nppc/MashController/README.md

# MashController

MashController is a home brewing automation project built to control the mash process with a small ESP8266-based controller. The goal is to make mash temperature easier to manage, more stable, and less dependent on constant manual intervention.

This project is designed for a brewer who wants a simple device that can measure temperature, control a heater, run a mixer, and expose a browser-based interface for monitoring and calibration.

## Safety Notice

This project is intended for educational and hobby use.
The software is provided without any warranty. Users are responsible for verifying that the system operates safely in their specific environment.
The author accepts no responsibility for any damage, injury, material loss, or other consequences resulting from the use of this project.
By using this software, you acknowledge that all operation is performed at your own risk.

## What this project does

During mashing, the temperature must stay within a fairly narrow range to support the desired enzymatic activity and conversion. MashController helps by continuously monitoring the mash temperature and adjusting the heating output to keep it near the target value. It also manages the mixer so the mash stays well mixed and the temperature remains consistent throughout the vessel.

## Heater temperature control logic

The heater control is model-based and predictive, not simple threshold switching. The controller keeps a calibrated thermal model of the heating element's stored heat, and on every cycle predicts the peak temperature the mash will coast to if the heater switched off right now — accounting for residual stored heat and loss to ambient.
It switches on when that predicted peak drops below target minus a deadband, and switches off once the predicted peak reaches target — turning off before the sensor shows target, anticipating the heat still flowing in. A minimum switch-lock interval prevents rapid cycling. The result: stable, repeatable mash temperature with minimal overshoot, since the controller reacts to where temperature is heading, not just where it is now.

> **Why not PID?** A PID controller suits outputs that can be varied smoothly and processes that respond quickly. Here the heater is only fully on or off, and the response is slow and delayed by stored heat, sensor lag and the mixer cycle. Even with autotuning, PID only works acceptably within a narrow setup window, and a different volume or mash needs retuning.

## Mixer logic

The mixer logic is intended to keep the mash moving while the heater is active. A mash can develop temperature gradients, especially in a vessel with a heating element near the bottom, where the liquid close to the heater becomes warmer than the rest. The mixer helps prevent that by circulating the mash and blending warmer and cooler zones together.

This improves consistency, reduces hot spots, and helps the system hold a more uniform temperature across the vessel.

## Profiles

A profile is a complete mash schedule: a list of temperature steps (up to 6), each with a target temperature and a duration. Up to 15 profiles can be stored on the device. They are edited on the Profiles screen and started from the Home screen, where the active step and remaining time are shown.

A step with its time set to 0 is a manual step: the controller heats to the target temperature and then waits until you press RESUME, for example to add grain. While a profile runs it can be paused, resumed, skipped to the next step or stopped. After the last step the mixer keeps running for a configurable cool-down time if needed.

The temperature chart shows an approximate program time remaining alongside the current ramp estimate. It includes estimated heating ramps and timed steps, pauses whenever the profile is paused, and excludes cooldown and manual waiting time.

Heater calibration is performed with plain water. During a mash, the controller adds an estimated grain heat capacity after you resume the first zero-duration manual step. Set that first step to the temperature where you add grain, add the grain when prompted, then press RESUME. The grain adjustment remains active for later steps. It accounts for grain mass, but does not model the grain's starting temperature or mixing effects.

When a manual step reaches its target temperature, the browser plays a soft chime, repeats it every 20 seconds until you press RESUME or STOP, and flashes the tab title. Browsers block sound until the page has been tapped once (for example after a refresh), so a yellow bar appears while a process is running to let you enable it. The alert can be switched off in Settings (**Sound Alerts**), and **Target Reached Tolerance** sets how many degrees below the target still counts as reached.

## Heater calibration

The DS18B20 sensor is factory-calibrated, so the sensor itself is not calibrated. What is calibrated is the **heater**. The element and pot base store heat, which keeps flowing into the water after switch-off, so the temperature overshoots. An automatic test on plain water (see the calibration page) measures the time constant (τ), effective power, store gain and heat loss of your setup, and the controller uses them to switch off early by the right amount.

> **Safety:** never leave the heater running unattended during calibration, and do not add grain.

## Features

- Temperature regulation for the mash process
- Heater control based on live sensor feedback
- Mixer control to keep the mash evenly mixed
- Mash profiles with up to 6 temperature steps each, including manual (wait for RESUME) steps, and up to 15 stored profiles
- Pause, resume and skip controls while a profile is running
- Audible browser alert when a manual step reaches its temperature
- Browser-based dashboard for monitoring and configuration
- Dual Wi-Fi modes: standalone Local Access Point (AP) and External Wi-Fi (Station) with automatic 2-minute AP fallback
- Local domain resolution via mDNS (`http://mash.local`) and NetBIOS (`http://mash`), configurable in Settings
- Emergency double-reset recovery to restore default AP credentials without losing settings, profiles, or calibration data
- Temporary simulated sensor mode and adjustable simulation speed for testing; real heater, mixer and cooler outputs are disabled in this mode
- Automatic heater calibration (time constant, effective power, store gain, heat loss)
- Over-the-Air (OTA) update support for both firmware and LittleFS filesystem images, with automatic GZIP compression (`.bin.gz`)

## Screenshots

<table>
  <tr>
    <td valign="top" align="center">
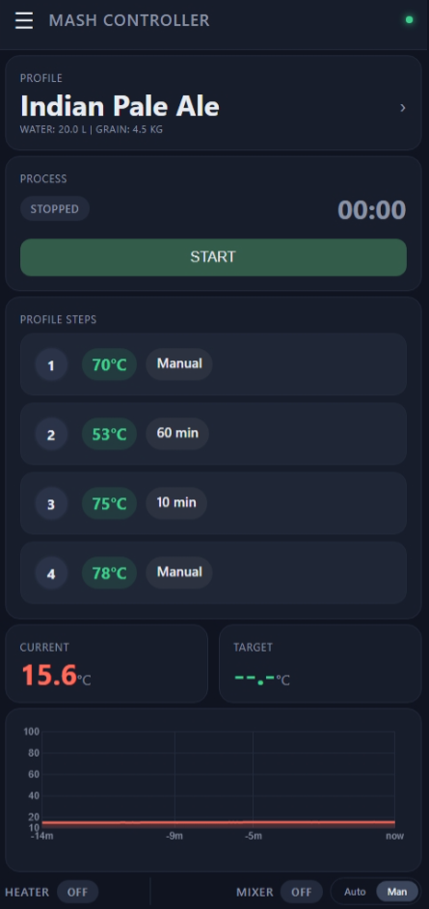
[picture p1: Images/main.png]
Main Dashboard
      <br>
      <b>Main Dashboard</b>
    </td>
    <td valign="top" align="center">
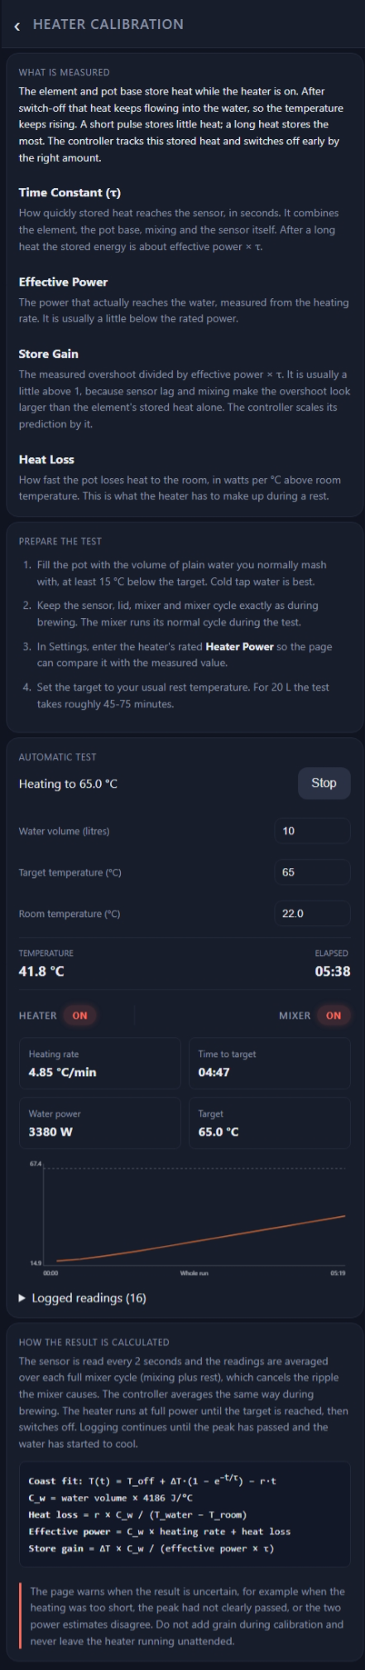
[picture p2: Images/calibration.png]
Heater Calibration
      <br>
      <b>Heater Calibration</b>
    </td>
  </tr>
</table>

## Hardware

The wiring diagram below shows how the Wemos D1 mini is connected to the sensor, heater, mixer and cooler.

<p align="center">
  MashController wiring schematic
</p>

### Parts

- Wemos D1 mini (ESP8266)
- DS18B20 temperature sensor with a 4.7 kΩ pull-up resistor to 3V3
- Solid-state relay (SSR), 25 A, for the heater (mains side)
- Heater element under the mash pot
- 19 V / 4.2 A AC/DC power adapter (notebook adapter)
- Buck (DC/DC) converter, 19 V to 5 V, for the Wemos and the fan
- Mixer driver (default, inverted): small-signal N-MOSFET (Q1) pulling down the gate of an IRFZ30 (Q2), with a 10 kΩ gate pull-up to the 19 V rail. A single logic-level N-MOSFET driven directly by the GPIO also works, see [Mixer drive polarity](#mixer-drive-polarity)
- Inverted drive only: 10 kΩ pull-up from D5 to 3V3, so the mixer stays off while the ESP8266 boots
- 24VDC mixer motor
- 5 V cooling fan for the SSR, switched by a second N-MOSFET module (optional, see below)

### Pin assignment

| Function | Wemos pin | Connected to |
| --- | --- | --- |
| `ONE_WIRE_BUS` | D1 | DS18B20 data (DQ) |
| `HEATER_PIN` | D2 | SSR input (IN+) |
| `MIXER_PIN` | D5 | Inverted drive (default): Q1 gate, active-low, GPIO LOW = mixer on. Non-inverted drive: MOSFET gate, active-high, GPIO HIGH = mixer on |
| `COOLER_PIN` | D6 | Fan MOSFET module (SIG) |

The pins are defined in `Config.h`.

### Mixer drive polarity

The mixer polarity is set by `MIXER_OUTPUT_INVERTED` in `Config.h`:

| `MIXER_OUTPUT_INVERTED` | Mixer driver | GPIO level for mixer on |
| --- | --- | --- |
| `1` (default) | Q1 pulling down the gate of Q2 (as in the schematic) | LOW |
| `0` | One logic-level N-MOSFET driven directly by the GPIO | HIGH |

Q1 inverts the signal, which is why the default drive is active-low. With a single N-MOSFET no inversion is needed, so set the define to `0`. Keep the mixer off while the ESP8266 boots: the 10 kΩ pull-up to 3V3 does this for the inverted drive, while a non-inverted drive needs a pull-down instead (for example 10 kΩ from the gate to GND).

**Fan control is optional.** The fan MOSFET module and `COOLER_PIN` (D6) can be omitted. In that case, connect the fan directly to the 5 V rail (fan + to 5 V, fan − to GND), and it will run continuously.

> **Warning:** the SSR switches mains voltage. Mount it on a heatsink, use a properly rated and enclosed installation, and never work on the mains wiring while it is connected to power. A flyback diode across the motor and the fan is recommended; it is not drawn in the schematic.

## Network and Wi-Fi

MashController provides two operating modes for Wi-Fi, selectable in Settings:

### 1. Local AP Mode (Default)
When active, the controller creates its own Wi-Fi Access Point:
- **Default SSID:** `MashController`
- **Default IP:** `192.168.4.1` (or `http://mash.local`)
- **Password:** Optional. Leave empty for an open network, or enter an 8+ character WPA2 password.

### 2. External Wi-Fi Mode (Station)
Connects to your home Wi-Fi network as a client:
- Automatically requests an IP address via DHCP (compatible with router DHCP Address Reservations).
- **Automatic AP Fallback:** If the external network cannot be reached within 2 minutes (e.g. router rebooting, out of range, or wrong password), the controller automatically starts its Local AP so you can still access the interface, while continuing background reconnection retries.

### Emergency AP Recovery (Double-Reset)
If you ever forget the AP password or lose network access:
- Power-cycle or press the hardware reset button **twice within 10 seconds**.
- The controller temporarily resets the AP credentials to default (`MashController`, open network), allowing you to connect and reconfigure. Your mash profiles and calibration parameters are preserved.

### Local Domain Resolution (mDNS & NetBIOS)
- When enabled (default), you can reach the controller by name without looking up its assigned IP:
  - **`http://mash.local`** via Multicast DNS (mDNS) on iOS, macOS, Android, Linux, and Windows.
  - **`http://mash`** on Windows via NetBIOS Name Service (NBNS).
- **Enable / Disable Toggle:** If you assign a static router DHCP/DNS reservation or prefer IP-only access, toggle **mash.local Domain** off in Settings. This cleanly shuts down both mDNS and NetBIOS responders.

## Over-The-Air (OTA) Updates

Firmware and LittleFS filesystem updates can be uploaded directly over Wi-Fi:

1. Open **`http://<controller-ip>/enable-ota`** in a browser to unlock the 5-minute update window.
2. Select your file:
   - **Firmware:** `.pio/build/d1_mini/firmware.bin` or compressed **`firmware.bin.gz`**
   - **LittleFS Filesystem:** `.pio/build/d1_mini/littlefs.bin` or compressed **`littlefs.bin.gz`**
3. Click upload. PlatformIO automatically generates both `.bin` and `.bin.gz` files on compile (`pio run` / `pio run --target buildfs`). Uploading `.bin.gz` files reduces transfer size by ~30% for firmware and ~80% for filesystem images; the bootloader decompresses them atomically on restart.

## Getting Started

1. Clone the repository.
2. Open the project in [PlatformIO](https://platformio.org/).
3. Build and upload the firmware to your ESP8266 board (`pio run --target upload`).
4. Build and upload the filesystem image (`pio run --target uploadfs`).
5. Power up the controller. Connect to the `MashController` Wi-Fi network and open `http://192.168.4.1` (or `http://mash.local`) in your browser.
6. In **Settings**, configure your network:
   - Keep **Local AP** mode or switch to **External Wi-Fi** to connect to your home router.
   - Adjust the **mash.local Domain** toggle if desired.
7. Run Autocalibration for your heater setup on the Calibration page.

## License

This project is licensed under the MIT License.
