nppc/MashController/MashController_pio/data/PredictivePeakDeadband.png

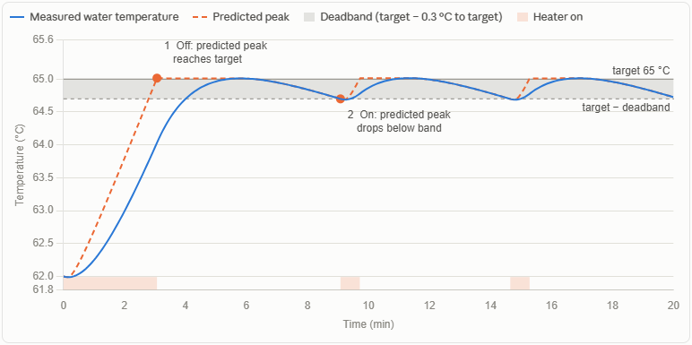
MashController_pio/data/PredictivePeakDeadband.png
