nppc/MashController/MashController_pio/include/Config.h

#ifndef CONFIG_H
#define CONFIG_H

#include <Arduino.h>

#define ONE_WIRE_BUS D1

// Heater SSR: driven directly, active-high (GPIO HIGH -> SSR on).
#define HEATER_PIN D2

// Mixer motor: GPIO drives a small-signal N-MOSFET which, in turn, pulls
// down the gate of the high-power IRFZ30 (pulled up externally to the
// gate-supply rail). That makes this channel ACTIVE-LOW from the GPIO's
// perspective:
//   GPIO HIGH -> small-signal FET ON  -> IRFZ30 gate LOW  -> motor OFF
//   GPIO LOW  -> small-signal FET OFF -> IRFZ30 gate HIGH -> motor ON
// Add an external pull-up (GPIO to 3.3V) on this pin so the motor
// defaults OFF during the boot window before setup() runs.
#define MIXER_PIN D5
// Set to 1 to keep the current active-low mixer drive behavior (GPIO HIGH = off).
// Set to 0 for a non-inverted drive (GPIO HIGH = on).
#define MIXER_OUTPUT_INVERTED 1

#define COOLER_PIN D6

#define HISTORY_SIZE 180
#define READ_INTERVAL_MS 2000UL
#define CONVERSION_TIME_MS 750UL   // 12-bit resolution conversion time

#define RESIDUAL_HEAT_RECOVERY_THRESHOLD_C 35.0f
#define RESIDUAL_HEAT_RECOVERY_WINDOW_MS 60000UL
#define RESIDUAL_HEAT_RECOVERY_MAX_RISE_C 0.1f

#endif
