nppc/MashController/MashController_pio/src/Storage.cpp

#include "Storage.h"

/* ============================================================================
 * HOW TO USE STORED SETTINGS ACROSS THIS PROJECT
 * ============================================================================
 *
 * `storage` (declared below) is the single global instance. Call
 * `storage.begin()` once from setup() before anything touches it; it loads
 * from EEPROM, migrates older layouts if needed, or writes defaults on first
 * boot / corruption.
 *
 * READING A SETTING (any .cpp file, anywhere in the project):
 *   #include "Storage.h"
 *   float ambient = storage.settings().heaterAmbientC;
 *
 *   `storage.settings()` returns a REFERENCE to the live in-RAM struct
 *   (_data.settings) - not a copy. There is no separate cache to go stale,
 *   so every read reflects the current value, including one changed a
 *   moment ago by a web handler on the same tick. This is how Sensor.cpp's
 *   fakeReadTemperature() picks up heaterAmbientC changes immediately.
 *
 * WRITING A SETTING (e.g. from a web handler):
 *   SettingsEE &s = storage.settings();
 *   s.heaterAmbientC = constrain(newValue, -10.0f, 45.0f);
 *   storage.save();   // <-- REQUIRED to persist to EEPROM
 *
 *   The struct mutation itself takes effect in RAM instantly, for every
 *   other piece of code holding or fetching a reference. `storage.save()`
 *   only controls whether the change SURVIVES A REBOOT - it recomputes the
 *   CRC and writes the whole `_data` blob via EEPROM.commit(). Skipping
 *   save() means the running system behaves correctly but reverts to the
 *   old value on next boot. Always constrain/validate before assigning;
 *   save() does not validate for you (see handleSaveSettings in
 *   WebHandlers.cpp for the pattern of per-field constrain() calls).
 *
 * PROFILES ARE DIFFERENT - NOT A LIVE REFERENCE:
 *   storage.getProfile(index, out)   // copies into `out`
 *   storage.setProfile(index, p)     // copies `p` in (index == count appends)
 *   storage.deleteProfile(index)
 *   storage.clearProfiles()
 *   Profiles are accessed by value, not by reference, so mutate your local
 *   copy and call setProfile() to write it back - then storage.save() to
 *   persist, same as settings.
 *

 * ADDING A NEW SETTING FIELD:
 *   1. Add the field to `SettingsEE` in Storage.h.
 *   2. Give it a sane default in applyHeaterDefaults() (heater-related),
 *      applyMixerDefaults() (mixer/cool-down) or directly in
 *      Storage::loadDefaults() (everything else). Every migration and
 *      loadDefaults() call these helpers first, so a field defaulted there
 *      never ends up as 0 after a memset().
 *   3. If this changes the struct's layout/size, bump STORAGE_VERSION.
 *      The static_assert next to LegacyV12SettingsEE will fail the build
 *      until you:
 *        (a) copy the OLD SettingsEE into a new LegacyV<old>SettingsEE /
 *            LegacyV<old>EepromDataEE pair,
 *        (b) delete the previous Legacy struct pair,
 *        (c) update STORAGE_PREVIOUS_VERSION in Storage.h,
 *        (d) rewrite the migration block in begin() for the new legacy
 *            struct (call the apply*Defaults() helpers, then copy over
 *            every field that existed before).
 *      POLICY: only ONE previous version is migrated. Anything older is
 *      reset to defaults by loadDefaults().
 *      If ProfileEE itself changes, also snapshot the old profile struct
 *      inside the Legacy pair (see how LegacyV10ProfileEE used to be done),
 *      because the Legacy layout embeds ProfileEE.
 * ==========================================================================
 */

Storage storage;

namespace {

// ---- Previous layout (version STORAGE_PREVIOUS_VERSION) -------------------
// Layout of version 15 (before mdnsEnabled was added).
struct LegacyV15SettingsEE {
  uint8_t  wifiMode;
  char     wifiApSSID[STORAGE_SSID_LEN];
  char     wifiApPass[STORAGE_PASS_LEN];
  char     wifiStaSSID[STORAGE_SSID_LEN];
  char     wifiStaPass[STORAGE_PASS_LEN];
  float    heaterPowerW;
  float    heaterPowerEffW;
  float    heaterTauSec;
  float    heaterStoreGain;
  float    heaterLossWPerC;
  float    heaterAmbientC;
  float    heaterDeadband;
  uint16_t heaterMinSwitchSec;
  float    heaterT1;
  float    heaterTau1;
  float    heaterLossW1;
  float    heaterStoreGain1;
  float    heaterT2;
  float    heaterTau2;
  float    heaterLossW2;
  float    heaterStoreGain2;
  float    heaterTrimLowC;
  float    heaterTrimHighC;
  float    heaterLossScalePct;
  uint8_t  mixerRestSec;
  uint8_t  mixerOnSec;
  uint16_t coolDownSec;
  float    targetReachedHystC;
  bool     alertSoundEnabled;
};

struct LegacyV15EepromDataEE {
  uint32_t             magic;
  uint16_t             version;
  LegacyV15SettingsEE  settings;
  uint8_t              profileCount;
  ProfileEE            profiles[STORAGE_MAX_PROFILES];
  uint32_t             crc;
};

// Build breaks here when STORAGE_VERSION is bumped without updating the
// migration. See "ADDING A NEW SETTING FIELD" at the top of this file.
static_assert(STORAGE_VERSION == STORAGE_PREVIOUS_VERSION + 1,
              "STORAGE_VERSION was bumped: snapshot the old SettingsEE as "
              "LegacyV<old>SettingsEE, update STORAGE_PREVIOUS_VERSION, "
              "migrate it in begin(), and delete the older Legacy struct.");
static_assert(STORAGE_PREVIOUS_VERSION == 15,
              "STORAGE_PREVIOUS_VERSION no longer matches LegacyV15* - "
              "rename/replace the Legacy struct and migration block.");

// Uncalibrated starting point for a 2 kW under-base element; run the
// Heater Calibration page to replace these with measured values.
void applyHeaterDefaults(SettingsEE &s) {
  s.heaterPowerW = 2000.0f;
  s.heaterPowerEffW = 1900.0f;
  s.heaterTauSec = 90.0f;
  s.heaterStoreGain = 1.0f;
  s.heaterLossWPerC = 4.0f;
  s.heaterAmbientC = 20.0f;
  s.heaterDeadband = 0.05f;
  s.heaterMinSwitchSec = 5;

  s.heaterT1 = 50.0f;
  s.heaterTau1 = 115.0f;
  s.heaterLossW1 = 65.0f;
  s.heaterStoreGain1 = 0.85f;
  s.heaterT2 = 70.0f;
  s.heaterTau2 = 95.0f;
  s.heaterLossW2 = 150.0f;
  s.heaterStoreGain2 = 0.88f;

  s.heaterTrimLowC = 0.0f;
  s.heaterTrimHighC = 0.0f;
  s.heaterLossScalePct = 100.0f;

  // Not heater values, but seeded here because every migration path and
  // loadDefaults() already call this helper.
  s.targetReachedHystC = 0.5f;   // was hardcoded in mashProfileTick()
  s.alertSoundEnabled = true;
  s.mdnsEnabled = true;
}

void applyMixerDefaults(SettingsEE &s) {
  s.mixerRestSec = 15;
  s.mixerOnSec   = 5;
  s.coolDownSec  = 180;   // 3 minutes default
}
}

bool Storage::begin() {
  EEPROM.begin(sizeof(EepromDataEE));
  EEPROM.get(0, _data);

  uint32_t storedCrc = _data.crc;
  uint32_t calc = crc32((uint8_t*)&_data, sizeof(EepromDataEE) - sizeof(_data.crc));

  if (_data.magic != STORAGE_MAGIC || _data.version != STORAGE_VERSION || storedCrc != calc) {
    LegacyV15EepromDataEE legacyV15;
    EEPROM.get(0, legacyV15);
    uint32_t legacyV15Calc = crc32(
        (uint8_t*)&legacyV15,
        sizeof(LegacyV15EepromDataEE) - sizeof(legacyV15.crc));

    if (legacyV15.magic == STORAGE_MAGIC &&
        legacyV15.version == STORAGE_PREVIOUS_VERSION &&
        legacyV15.crc == legacyV15Calc) {
      memset(&_data, 0, sizeof(_data));
      _data.magic = STORAGE_MAGIC;
      _data.version = STORAGE_VERSION;

      applyHeaterDefaults(_data.settings);
      applyMixerDefaults(_data.settings);

      _data.settings.wifiMode = legacyV15.settings.wifiMode;
      memcpy(_data.settings.wifiApSSID, legacyV15.settings.wifiApSSID, STORAGE_SSID_LEN);
      memcpy(_data.settings.wifiApPass, legacyV15.settings.wifiApPass, STORAGE_PASS_LEN);
      memcpy(_data.settings.wifiStaSSID, legacyV15.settings.wifiStaSSID, STORAGE_SSID_LEN);
      memcpy(_data.settings.wifiStaPass, legacyV15.settings.wifiStaPass, STORAGE_PASS_LEN);

      _data.settings.heaterPowerW = legacyV15.settings.heaterPowerW;
      _data.settings.heaterPowerEffW = legacyV15.settings.heaterPowerEffW;
      _data.settings.heaterTauSec = legacyV15.settings.heaterTauSec;
      _data.settings.heaterStoreGain = legacyV15.settings.heaterStoreGain;
      _data.settings.heaterLossWPerC = legacyV15.settings.heaterLossWPerC;
      _data.settings.heaterAmbientC = legacyV15.settings.heaterAmbientC;
      _data.settings.heaterDeadband = legacyV15.settings.heaterDeadband;
      _data.settings.heaterMinSwitchSec = legacyV15.settings.heaterMinSwitchSec;
      _data.settings.heaterT1 = legacyV15.settings.heaterT1;
      _data.settings.heaterTau1 = legacyV15.settings.heaterTau1;
      _data.settings.heaterLossW1 = legacyV15.settings.heaterLossW1;
      _data.settings.heaterStoreGain1 = legacyV15.settings.heaterStoreGain1;
      _data.settings.heaterT2 = legacyV15.settings.heaterT2;
      _data.settings.heaterTau2 = legacyV15.settings.heaterTau2;
      _data.settings.heaterLossW2 = legacyV15.settings.heaterLossW2;
      _data.settings.heaterStoreGain2 = legacyV15.settings.heaterStoreGain2;
      _data.settings.heaterTrimLowC = legacyV15.settings.heaterTrimLowC;
      _data.settings.heaterTrimHighC = legacyV15.settings.heaterTrimHighC;
      _data.settings.heaterLossScalePct = legacyV15.settings.heaterLossScalePct;
      _data.settings.mixerRestSec = legacyV15.settings.mixerRestSec;
      _data.settings.mixerOnSec = legacyV15.settings.mixerOnSec;
      _data.settings.coolDownSec = legacyV15.settings.coolDownSec;
      _data.settings.targetReachedHystC = legacyV15.settings.targetReachedHystC;
      _data.settings.alertSoundEnabled = legacyV15.settings.alertSoundEnabled;
      _data.settings.mdnsEnabled = true;

      _data.profileCount = min(legacyV15.profileCount,
                               (uint8_t)STORAGE_MAX_PROFILES);
      memcpy(_data.profiles, legacyV15.profiles,
             sizeof(ProfileEE) * _data.profileCount);
      Serial.println("Storage: migrated version 15 settings");
      save();
      return true;
    }

    Serial.println("Storage: no valid data found (first boot, corrupted or too old) - writing defaults");
    loadDefaults();
    save();
    return false;
  }

  Serial.print("Storage: loaded OK, ");
  Serial.print(_data.profileCount);
  Serial.println(" profile(s)");
  return true;
}

void Storage::loadDefaults() {
  memset(&_data, 0, sizeof(_data));
  _data.magic   = STORAGE_MAGIC;
  _data.version = STORAGE_VERSION;

  _data.settings.wifiMode = WIFI_MODE_AP;
  strncpy(_data.settings.wifiApSSID, "MashController", STORAGE_SSID_LEN - 1);
  _data.settings.wifiApSSID[STORAGE_SSID_LEN - 1] = '\0';
  _data.settings.wifiApPass[0] = '\0';
  _data.settings.wifiStaSSID[0] = '\0';
  _data.settings.wifiStaPass[0] = '\0';
  _data.settings.mdnsEnabled = true;

  applyHeaterDefaults(_data.settings);
  applyMixerDefaults(_data.settings);

  _data.profileCount = 0;

  // Seed one basic profile so the frontend never has to deal with an empty
  // list on first boot / after a corrupted EEPROM.
  ProfileEE defaultProfile;
  memset(&defaultProfile, 0, sizeof(defaultProfile));
  strncpy(defaultProfile.name, "Default", STORAGE_NAME_LEN - 1);
  defaultProfile.stepCount = 1;
  defaultProfile.waterMassKg = 20.0f;
  defaultProfile.grainMassKg = 5.0f;
  defaultProfile.steps[0].temp    = 67.0f;
  defaultProfile.steps[0].timeMin = 60;

  _data.profiles[_data.profileCount] = defaultProfile;
  _data.profileCount++;
}

bool Storage::save() {
  _data.crc = crc32((uint8_t*)&_data, sizeof(EepromDataEE) - sizeof(_data.crc));
  EEPROM.put(0, _data);
  bool ok = EEPROM.commit();
  if (!ok) Serial.println("Storage: EEPROM commit failed");
  return ok;
}

SettingsEE& Storage::settings() {
  return _data.settings;
}

uint8_t Storage::profileCount() const {
  return _data.profileCount;
}

bool Storage::getProfile(uint8_t index, ProfileEE &out) const {
  if (index >= _data.profileCount) return false;
  out = _data.profiles[index];
  return true;
}

bool Storage::setProfile(uint8_t index, const ProfileEE &p) {
  if (index < _data.profileCount) {
    _data.profiles[index] = p;
    return true;
  }
  if (index == _data.profileCount && _data.profileCount < STORAGE_MAX_PROFILES) {
    _data.profiles[_data.profileCount] = p;
    _data.profileCount++;
    return true;
  }
  return false; // out of range, or storage full
}

bool Storage::deleteProfile(uint8_t index) {
  if (index >= _data.profileCount) return false;
  for (uint8_t i = index; i < _data.profileCount - 1; i++) {
    _data.profiles[i] = _data.profiles[i + 1];
  }
  _data.profileCount--;
  return true;
}

void Storage::clearProfiles() {
  _data.profileCount = 0;
}

// Standard CRC32 (poly 0xEDB88320), bitwise - no table needed, only runs
// a handful of times (on boot and on save), so speed doesn't matter here.
uint32_t Storage::crc32(const uint8_t *data, size_t length) const {
  uint32_t crc = 0xFFFFFFFF;
  for (size_t i = 0; i < length; i++) {
    crc ^= data[i];
    for (uint8_t bit = 0; bit < 8; bit++) {
      crc = (crc & 1) ? (crc >> 1) ^ 0xEDB88320UL : (crc >> 1);
    }
  }
  return ~crc;
}
