nppc/MashController/MashController_pio/src/WebHandlers.cpp

#include "WebHandlers.h"

#include <LittleFS.h>
#include <ESP8266WiFi.h>
#include <ArduinoJson.h>
#include <ArduinoOTA.h>
#include <Updater.h>
#include <Ticker.h>
#include <flash_hal.h>

#include "Storage.h"
#include "Sensor.h"
#include "Heater.h"
#include "Calibration.h"
#include "Mixer.h"
#include "MashProfile.h"
#include "Outputs.h"

static double round1(double v) { return round(v * 10.0) / 10.0; }

ESP8266WebServer server(80);
bool otaEnabled = false;

namespace {
Ticker restartTicker;

void scheduleRestart(uint32_t delayMs = 1000) {
  restartTicker.once_ms(delayMs, []() {
    ESP.restart();
  });
}

bool otaStarted = false;
unsigned long otaActivatedAt = 0;
constexpr unsigned long OTA_TIMEOUT_MS = 5UL * 60UL * 1000UL;
bool updateFailed = false;
bool updateReceived = false;

bool isFilesystemImage(const String &filename) {
  String lowerName = filename;
  lowerName.toLowerCase();
  return lowerName.indexOf("littlefs") >= 0 ||
         lowerName.indexOf("filesystem") >= 0 ||
         lowerName.indexOf("spiffs") >= 0 ||
         (lowerName.indexOf("fs") >= 0 && (lowerName.endsWith(".bin") || lowerName.endsWith(".gz")));
}

size_t filesystemSize() {
  FSInfo info;
  if (LittleFS.info(info) && info.totalBytes > 0 && info.totalBytes <= (size_t)FS_PHYS_SIZE) {
    return info.totalBytes;
  }
  return (size_t)FS_PHYS_SIZE;
}
}

/* -------------------------------------------------------------------------- */
/*                               FILE HANDLING                                */
/* -------------------------------------------------------------------------- */

static void handleFileRead(String path) {
  if (path.endsWith("/")) path += "index.html";

  String contentType = "text/html";
  if (path.endsWith(".css"))  contentType = "text/css";
  if (path.endsWith(".js"))   contentType = "application/javascript";
  if (path.endsWith(".json")) contentType = "application/json";
  if (path.endsWith(".ico")) contentType = "image/x-icon";

  // --- NEW: check gzip version first ---
  String gzPath = path + ".gz";
  if (LittleFS.exists(gzPath)) {
    File file = LittleFS.open(gzPath, "r");

    // apply same caching rules for gzipped version
    if (path == "/ota.html" || path == "/reboot.html" || path == "/reboot.htm") {
      server.sendHeader("Cache-Control", "no-store, no-cache, must-revalidate");
      server.sendHeader("Pragma", "no-cache");
    } else if (path == "/chart.js" || path.endsWith(".png")) {
      server.sendHeader("Cache-Control", "public, max-age=31536000, immutable");
    } else if (path == "/style.css" || path == "/script.js" || path == "/calibration.js") {
      server.sendHeader("Cache-Control", "public, max-age=3600");
    }

    server.streamFile(file, contentType);   // ESP adds Content-Encoding: gzip automatically
    file.close();
    return;
  }

  // --- normal (non-gz) version ---
  if (LittleFS.exists(path)) {
    File file = LittleFS.open(path, "r");

    if (path == "/ota.html" || path == "/reboot.html" || path == "/reboot.htm") {
      server.sendHeader("Cache-Control", "no-store, no-cache, must-revalidate");
      server.sendHeader("Pragma", "no-cache");
    } else if (path == "/chart.js" || path.endsWith(".png")) {
      server.sendHeader("Cache-Control", "public, max-age=31536000, immutable");
    } else if (path == "/style.css" || path == "/script.js" || path == "/calibration.js") {
      server.sendHeader("Cache-Control", "public, max-age=3600");
    }

    server.streamFile(file, contentType);
    file.close();
    return;
  }

  server.send(404, "text/plain", "Not found");
}

/* -------------------------------------------------------------------------- */
/*                         PROFILES (REST API, EEPROM)                        */
/* -------------------------------------------------------------------------- */

static void handleGetProfiles() {
  // Current storage allows up to 15 profiles x 6 steps each; keep a margin above
  // the worst-case serialized payload for names, floats, and nested arrays.
  DynamicJsonDocument doc(4096);
  JsonArray arr = doc.createNestedArray("profiles");

  for (uint8_t i = 0; i < storage.profileCount(); i++) {
    ProfileEE p;
    if (!storage.getProfile(i, p)) continue;

    JsonObject o = arr.createNestedObject();
    o["name"] = p.name;
    o["waterMassKg"] = p.waterMassKg;
    o["grainMassKg"] = round1(p.grainMassKg);

    JsonArray steps = o.createNestedArray("steps");
    for (uint8_t s = 0; s < p.stepCount; s++) {
      JsonObject st = steps.createNestedObject();
      st["temp"] = round1(p.steps[s].temp);
      st["time"] = p.steps[s].timeMin;
    }
  }

  String out;
  serializeJson(doc, out);
  server.send(200, "application/json", out);
}

static void handleSaveProfiles() {
  String body = server.arg("plain");
  Serial.println("---- /saveProfiles ----");

  if (body.length() == 0) {
    server.send(400, "text/plain", "No JSON received");
    return;
  }

  DynamicJsonDocument doc(4096);
  DeserializationError err = deserializeJson(doc, body);
  if (err) {
    server.send(400, "text/plain", "JSON parse error");
    return;
  }

  JsonArray arr = doc["profiles"].as<JsonArray>();
  if (arr.isNull()) {
    server.send(400, "text/plain", "Missing 'profiles' array");
    return;
  }

  if (arr.size() > STORAGE_MAX_PROFILES) {
    server.send(400, "text/plain", "Too many profiles (max " + String(STORAGE_MAX_PROFILES) + ")");
    return;
  }

  // Whole-list replace, mirrors the old file-overwrite behaviour but now on EEPROM.
  storage.clearProfiles();

  for (JsonObject p : arr) {
    ProfileEE pe;
    memset(&pe, 0, sizeof(pe));

    const char *name = p["name"] | "Profile";
    strncpy(pe.name, name, STORAGE_NAME_LEN - 1);
    pe.waterMassKg = max(p["waterMassKg"].as<float>(), 0.1f);
    pe.grainMassKg = max(p["grainMassKg"].as<float>(), 0.0f);

    JsonArray steps = p["steps"].as<JsonArray>();
    pe.stepCount = min((int)steps.size(), (int)STORAGE_MAX_STEPS);

    for (uint8_t i = 0; i < pe.stepCount; i++) {
      pe.steps[i].temp    = steps[i]["temp"].as<float>();
      pe.steps[i].timeMin = steps[i]["time"].as<int>();
    }

    storage.setProfile(storage.profileCount(), pe);
  }

  if (!storage.save()) {
    server.send(500, "text/plain", "EEPROM write error");
    return;
  }

  Serial.println("Profiles saved to EEPROM");
  server.send(200, "text/plain", "Saved");
}

static void handleCalibrationStart() {
  const float waterLiters = server.arg("liters").toFloat();
  const float targetC = server.hasArg("target") ? server.arg("target").toFloat() : 65.0f;
  const float ambientC = server.hasArg("ambient") ? server.arg("ambient").toFloat() : 20.0f;
  if (!calibrationStart(waterLiters, targetC, ambientC)) {
    server.send(409, "text/plain", calibrationLastError());
    return;
  }
  server.send(200, "text/plain", "Calibration started");
}

static void handleCalibrationStop() {
  calibrationStop();
  server.send(200, "text/plain", "Calibration stopped");
}

static void handleCalibrationStatus() {
  const long since = server.hasArg("since") ? server.arg("since").toInt() : 0;
  String out;
  calibrationStatusJson(out, (uint16_t)constrain(since, 0L, 65535L));
  server.send(200, "application/json", out);
}

/* -------------------------------------------------------------------------- */
/*                         SETTINGS (REST API, EEPROM)                        */
/* -------------------------------------------------------------------------- */

static void handleGetSettings() {
  SettingsEE &s = storage.settings();
  StaticJsonDocument<768> doc;

  doc["wifiMode"] = s.wifiMode;
  doc["wifiApSSID"] = s.wifiApSSID;
  doc["wifiApPassSet"] = strlen(s.wifiApPass) > 0;
  doc["wifiStaSSID"] = s.wifiStaSSID;
  doc["wifiStaPassSet"] = strlen(s.wifiStaPass) > 0;

  // Backward compatibility: legacy single wifiSSID field
  doc["wifiSSID"] = (s.wifiMode == WIFI_MODE_STA) ? s.wifiStaSSID : s.wifiApSSID;
  doc["wifiPassSet"] = (s.wifiMode == WIFI_MODE_STA) ? (strlen(s.wifiStaPass) > 0) : (strlen(s.wifiApPass) > 0);

  const WiFiMode_t wifiMode = WiFi.getMode();
  const bool stationEnabled = (wifiMode & WIFI_STA) != 0;
  const bool apEnabled = (wifiMode & WIFI_AP) != 0;
  const bool isStaConnected =
      stationEnabled && WiFi.status() == WL_CONNECTED &&
      WiFi.localIP() != IPAddress(0, 0, 0, 0);
  doc["wifiActiveMode"] = stationEnabled
                              ? (apEnabled ? "AP+STA" : "STA")
                              : "AP";
  doc["wifiConnected"] = stationEnabled ? isStaConnected : apEnabled;
  doc["wifiIP"] = isStaConnected
                      ? WiFi.localIP().toString()
                      : (apEnabled ? WiFi.softAPIP().toString()
                                   : String("Disconnected"));
  doc["wifiMac"] = isStaConnected || !apEnabled
                       ? WiFi.macAddress()
                       : WiFi.softAPmacAddress();

  doc["heaterPowerW"] = s.heaterPowerW;
  doc["heaterPowerEffW"] = s.heaterPowerEffW;
  doc["heaterTauSec"] = s.heaterTauSec;
  doc["heaterStoreGain"] = s.heaterStoreGain;
  doc["heaterLossWPerC"] = s.heaterLossWPerC;
  doc["heaterAmbientC"] = s.heaterAmbientC;
  doc["heaterDeadband"] = HEATER_DEADBAND_C;
  doc["heaterMinSwitchSec"] = s.heaterMinSwitchSec;

  doc["heaterT1"] = s.heaterT1;
  doc["heaterTau1"] = s.heaterTau1;
  doc["heaterLossW1"] = s.heaterLossW1;
  doc["heaterStoreGain1"] = s.heaterStoreGain1;
  doc["heaterT2"] = s.heaterT2;
  doc["heaterTau2"] = s.heaterTau2;
  doc["heaterLossW2"] = s.heaterLossW2;
  doc["heaterStoreGain2"] = s.heaterStoreGain2;

  doc["heaterTrimLowC"] = s.heaterTrimLowC;
  doc["heaterTrimHighC"] = s.heaterTrimHighC;
  doc["heaterLossScalePct"] = s.heaterLossScalePct;
  doc["mixerOnSec"] = s.mixerOnSec;
  doc["mixerRestSec"] = s.mixerRestSec;
  doc["coolDownSec"] = s.coolDownSec;
  doc["targetReachedHystC"] = s.targetReachedHystC;
  doc["alertSoundEnabled"] = s.alertSoundEnabled;
  doc["mdnsEnabled"] = s.mdnsEnabled;

  // Sensor source and live DS18B20 information.
  doc["sensorDebugFake"] = sensorUsingFakeMode();
  doc["sensorDebugSpeed"] = sensorFakeSpeedMultiplier();
  doc["sensorAddress"] = sensorUsingFakeMode() ? "SIMULATED" : sensorAddressToString();
  doc["sensorFound"] = sensorFound;
  doc["sensorTempAtRead"] = lastGoodTemp;
  doc["sensorOk"] = sensorOk;

  String out;
  serializeJson(doc, out);
  server.send(200, "application/json", out);
}

static void handleSaveSettings() {
  String body = server.arg("plain");
  if (body.length() == 0) {
    server.send(400, "text/plain", "No JSON received");
    return;
  }

  StaticJsonDocument<768> doc;
  DeserializationError err = deserializeJson(doc, body);
  if (err) {
    server.send(400, "text/plain", "JSON parse error");
    return;
  }

  if (doc.containsKey("sensorDebugFake") &&
      !doc["sensorDebugFake"].is<bool>()) {
    server.send(400, "text/plain", "sensorDebugFake must be a boolean");
    return;
  }
  if (doc.containsKey("sensorDebugSpeed") &&
      (!doc["sensorDebugSpeed"].is<float>() ||
       doc["sensorDebugSpeed"].as<float>() < 1.0f ||
       doc["sensorDebugSpeed"].as<float>() > 20.0f)) {
    server.send(400, "text/plain", "sensorDebugSpeed must be between 1 and 20");
    return;
  }
  if (doc.containsKey("sensorDebugFake") &&
      doc["sensorDebugFake"].as<bool>() != sensorUsingFakeMode() &&
      (isRunning || inCoolDown || calibrationIsActive())) {
    server.send(409, "text/plain", "Stop the mash or calibration before changing sensor mode");
    return;
  }
  const bool requestedFakeMode =
      doc.containsKey("sensorDebugFake")
          ? doc["sensorDebugFake"].as<bool>()
          : sensorUsingFakeMode();
  if (doc.containsKey("sensorDebugSpeed") &&
      doc["sensorDebugSpeed"].as<float>() != sensorFakeSpeedMultiplier() &&
      requestedFakeMode && (isRunning || inCoolDown || calibrationIsActive())) {
    server.send(409, "text/plain", "Stop the mash or calibration before changing simulation speed");
    return;
  }

  SettingsEE &s = storage.settings();

  if (doc.containsKey("wifiMode")) {
    s.wifiMode = (doc["wifiMode"].as<uint8_t>() == 1) ? WIFI_MODE_STA : WIFI_MODE_AP;
  }

  // Backward compatibility: handle legacy single wifiSSID field from cached UI
  if (doc.containsKey("wifiSSID") && !doc.containsKey("wifiApSSID") && !doc.containsKey("wifiStaSSID")) {
    const char *oldSsid = doc["wifiSSID"] | "";
    if (s.wifiMode == WIFI_MODE_STA) {
      strncpy(s.wifiStaSSID, oldSsid, STORAGE_SSID_LEN - 1);
      s.wifiStaSSID[STORAGE_SSID_LEN - 1] = '\0';
    } else {
      strncpy(s.wifiApSSID, oldSsid, STORAGE_SSID_LEN - 1);
      s.wifiApSSID[STORAGE_SSID_LEN - 1] = '\0';
    }
  }

  // Backward compatibility: handle legacy single wifiPass field from cached UI
  if (doc.containsKey("wifiPass") && !doc.containsKey("wifiApPass") && !doc.containsKey("wifiStaPass")) {
    const char *oldPass = doc["wifiPass"] | "";
    if (strlen(oldPass) > 0) {
      if (s.wifiMode == WIFI_MODE_STA) {
        strncpy(s.wifiStaPass, oldPass, STORAGE_PASS_LEN - 1);
        s.wifiStaPass[STORAGE_PASS_LEN - 1] = '\0';
      } else {
        strncpy(s.wifiApPass, oldPass, STORAGE_PASS_LEN - 1);
        s.wifiApPass[STORAGE_PASS_LEN - 1] = '\0';
      }
    }
  }

  if (doc.containsKey("wifiApSSID")) {
    const char *apSsid = doc["wifiApSSID"] | "";
    if (strlen(apSsid) > 0) {
      strncpy(s.wifiApSSID, apSsid, STORAGE_SSID_LEN - 1);
      s.wifiApSSID[STORAGE_SSID_LEN - 1] = '\0';
    }
  }

  if (doc.containsKey("wifiApPass") && strlen(doc["wifiApPass"] | "") > 0) {
    const char *password = doc["wifiApPass"] | "";
    if (strlen(password) < 8) {
      server.send(400, "text/plain", "AP password must be at least 8 characters (or empty for open)");
      return;
    }
    strncpy(s.wifiApPass, password, STORAGE_PASS_LEN - 1);
    s.wifiApPass[STORAGE_PASS_LEN - 1] = '\0';
  } else if (doc["wifiApPassClear"].as<bool>()) {
    s.wifiApPass[0] = '\0';
  }

  if (doc.containsKey("wifiStaSSID")) {
    strncpy(s.wifiStaSSID, doc["wifiStaSSID"] | "", STORAGE_SSID_LEN - 1);
    s.wifiStaSSID[STORAGE_SSID_LEN - 1] = '\0';
  }

  if (doc.containsKey("wifiStaPass") && strlen(doc["wifiStaPass"] | "") > 0) {
    strncpy(s.wifiStaPass, doc["wifiStaPass"] | "", STORAGE_PASS_LEN - 1);
    s.wifiStaPass[STORAGE_PASS_LEN - 1] = '\0';
  } else if (doc["wifiStaPassClear"].as<bool>()) {
    s.wifiStaPass[0] = '\0';
  }
  if (doc["heaterPowerW"].is<float>()) {
    s.heaterPowerW = constrain(doc["heaterPowerW"].as<float>(), 1.0f, 10000.0f);
  }
  if (doc["heaterPowerEffW"].is<float>()) {
    s.heaterPowerEffW = constrain(doc["heaterPowerEffW"].as<float>(), 1.0f, 10000.0f);
  }
  if (doc["heaterTauSec"].is<float>()) {
    s.heaterTauSec = constrain(doc["heaterTauSec"].as<float>(), 5.0f, 1200.0f);
  }
  if (doc["heaterStoreGain"].is<float>()) {
    s.heaterStoreGain = constrain(doc["heaterStoreGain"].as<float>(), 0.2f, 5.0f);
  }
  if (doc["heaterLossWPerC"].is<float>()) {
    s.heaterLossWPerC = constrain(doc["heaterLossWPerC"].as<float>(), 0.0f, 100.0f);
  }
  if (doc["heaterAmbientC"].is<float>()) {
    s.heaterAmbientC = constrain(doc["heaterAmbientC"].as<float>(), -10.0f, 45.0f);
  }
  if (doc["heaterTrimLowC"].is<float>()) {
    s.heaterTrimLowC = constrain(doc["heaterTrimLowC"].as<float>(), -1.0f, 1.0f);
  }
  if (doc["heaterTrimHighC"].is<float>()) {
    s.heaterTrimHighC = constrain(doc["heaterTrimHighC"].as<float>(), -1.0f, 1.0f);
  }
  if (doc["heaterLossScalePct"].is<float>()) {
    s.heaterLossScalePct = constrain(doc["heaterLossScalePct"].as<float>(), 50.0f, 200.0f);
  }

  if (doc["heaterT1"].is<float>()) s.heaterT1 = doc["heaterT1"].as<float>();
  if (doc["heaterTau1"].is<float>()) s.heaterTau1 = constrain(doc["heaterTau1"].as<float>(), 10.0f, 600.0f);
  if (doc["heaterLossW1"].is<float>()) s.heaterLossW1 = constrain(doc["heaterLossW1"].as<float>(), 0.0f, 1000.0f);
  if (doc["heaterStoreGain1"].is<float>()) s.heaterStoreGain1 = constrain(doc["heaterStoreGain1"].as<float>(), 0.2f, 3.0f);

  if (doc["heaterT2"].is<float>()) s.heaterT2 = doc["heaterT2"].as<float>();
  if (doc["heaterTau2"].is<float>()) s.heaterTau2 = constrain(doc["heaterTau2"].as<float>(), 10.0f, 600.0f);
  if (doc["heaterLossW2"].is<float>()) s.heaterLossW2 = constrain(doc["heaterLossW2"].as<float>(), 0.0f, 1000.0f);
  if (doc["heaterStoreGain2"].is<float>()) s.heaterStoreGain2 = constrain(doc["heaterStoreGain2"].as<float>(), 0.2f, 3.0f);
  if (doc.containsKey("heaterDeadband")) {
    s.heaterDeadband = doc["heaterDeadband"].as<float>();
  }
  if (doc.containsKey("heaterMinSwitchSec")) {
    s.heaterMinSwitchSec = doc["heaterMinSwitchSec"].as<uint16_t>();
  }
  if (doc.containsKey("mixerOnSec")) {
    s.mixerOnSec = doc["mixerOnSec"].as<uint8_t>();
  }
  if (doc.containsKey("mixerRestSec")) {
    s.mixerRestSec = doc["mixerRestSec"].as<uint8_t>();
  }

  if (doc.containsKey("coolDownSec")) {
    s.coolDownSec = doc["coolDownSec"].as<uint16_t>();
  }

  if (doc["targetReachedHystC"].is<float>()) {
    s.targetReachedHystC = constrain(doc["targetReachedHystC"].as<float>(), 0.0f, 5.0f);
  }
  if (doc["alertSoundEnabled"].is<bool>()) {
    s.alertSoundEnabled = doc["alertSoundEnabled"].as<bool>();
  }
  if (doc["mdnsEnabled"].is<bool>()) {
    s.mdnsEnabled = doc["mdnsEnabled"].as<bool>();
    setMdnsEnabled(s.mdnsEnabled);
  }

  if (!storage.save()) {
    server.send(500, "text/plain", "EEPROM write error");
    return;
  }

  if (doc.containsKey("sensorDebugSpeed") &&
      !sensorSetFakeSpeedMultiplier(doc["sensorDebugSpeed"].as<float>())) {
    server.send(409, "text/plain", "Stop the mash or calibration before changing simulation speed");
    return;
  }
  if (doc.containsKey("sensorDebugFake") &&
      !sensorSetFakeMode(doc["sensorDebugFake"].as<bool>())) {
    server.send(409, "text/plain", "Stop the mash or calibration before changing sensor mode");
    return;
  }

  // wifiSSID/wifiPass only take effect on next boot since WiFi.softAP()
  // already ran in setup() by the time this request arrives.
  server.send(200, "text/plain",
              "Settings saved. Sensor mode and speed reset after reboot; Wi-Fi changes apply after reboot.");
}

static void handleRediscoverSensor() {
  if (sensorUsingFakeMode()) {
    server.send(409, "text/plain", "Disable the simulated sensor before rediscovering the DS18B20");
    return;
  }

  // Don't rediscover mid-conversion - wait for the current read cycle to finish
  if (conversionInProgress) {
    server.send(409, "text/plain", "Sensor read in progress, try again shortly");
    return;
  }

  sensorFound = discoverSensorAddress();

  if (sensorFound) {
    sensors.setResolution(sensorAddr, 12);
    server.send(200, "application/json",
      "{\"sensorFound\":true,\"sensorAddress\":\"" + sensorAddressToString() + "\"}");
  } else {
    server.send(200, "application/json", "{\"sensorFound\":false}");
  }
}

/* -------------------------------------------------------------------------- */
/*                               API ENDPOINTS                                */
/* -------------------------------------------------------------------------- */

static void handleData() {
  DynamicJsonDocument doc(3072); // TODO: when wil migrate to chunks, then 2048 will be wnough
  JsonArray temps = doc.createNestedArray("temps");
  int count = min(histIndex, HISTORY_SIZE);
  int start = (histIndex > HISTORY_SIZE) ? histIndex % HISTORY_SIZE : 0;
  for (int i = 0; i < count; i++) {
    int idx = (start + i) % HISTORY_SIZE;
    temps.add(round1(tempHistory[idx] / 100.0f));
  }
  doc["target"] = round1(targetTemperature);  // NaN -> null automatically

  const float eta = heaterEstimatedSecondsToTarget();
  if (isfinite(eta)) doc["etaSec"] = (long)eta;
  const float programEta = mashProfileEstimatedSecondsRemaining();
  if (isfinite(programEta)) doc["programEtaSec"] = (long)programEta;

  String out;
  serializeJson(doc, out);
  server.send(200, "application/json", out);
}

static void handleStartProfile() {
  if (calibrationIsActive()) {
    server.send(409, "text/plain", "Calibration is running");
    return;
  }

  int idx = server.arg("profile").toInt();

  if (!loadProfile(idx)) {
    server.send(500, "text/plain", "Profile load error");
    return;
  }

  currentStep = 0;
  isRunning = true;
  isPaused = false;
  waitingForUser = false;
  inCoolDown = false;

  targetTemperature = activeProfile.steps[0].temp;
  heaterResetThermalModel(readTemperature(), activeProfile.waterMassKg);
  if (sensorUsingFakeMode()) {
    sensorPrepareFakeMash(activeProfile.waterMassKg, readTemperature());
  }

  // Do NOT start timer yet
  waitingForTemp = true;
  stepDurationSec = activeProfile.steps[0].time * 60;
  pausedElapsedSec = 0;
  mashProfileResetEstimatedTime();

  // Hand the mixer to auto, starting a fresh rest phase, regardless of
  // whatever mode/state it was left in before the mash started.
  mixerManualMode = false;
  mixerOn = false;
  mixerPhaseStart = millis();
  mashProfileStartResidualHeatRecovery();

  server.send(200, "text/plain", "Started");
}

static void handleStopProfile() {
  isRunning = false;
  isPaused = false;
  waitingForUser = false;
  waitingForTemp = false;
  residualHeatRecoveryActive = false;
  targetTemperature = NAN;
  heaterOn = false;
  mashProfileResetEstimatedTime();

  // Mixer shouldn't keep cycling with nothing being mashed.
  mixerManualMode = true;
  mixerOn = false;

  inCoolDown = false;         // EXIT COOL-DOWN IF ACTIVE

  server.send(200, "text/plain", "Stopped");
}

static void handlePauseProfile() {
  if (isRunning && !isPaused) {
    if (!waitingForTemp) {
      unsigned long elapsed = (millis() - stepStartTime) / 1000;
      pausedElapsedSec = elapsed;
    }
    isPaused = true;

    if (waitingForTemp || waitingForUser) {
      // Heating and automatic mixing are stopped before the timer starts.
      mixerManualMode = true;
      mixerOn = false;
    } else {
      // During a timed hold, pause only the timer and keep temperature
      // control and automatic mixing active.
      mixerManualMode = false;
      mixerOn = false;
      mixerPhaseStart = millis();
    }
  }
  server.send(200, "text/plain", "Paused");
}

static void handleResumeProfile() {
  if (isRunning && isPaused) {
    if (waitingForUser) {
      if (currentStep == 0) {
        heaterIncludeGrain(activeProfile.grainMassKg);
        if (sensorUsingFakeMode()) {
          sensorAddFakeGrain(activeProfile.grainMassKg);
        }
        sensorResetControlTemperatureHistory();
        heaterRebaseAfterGrainAddition();
      }
      waitingForUser = false;
      isPaused = false;
      advanceStep();
    } else {
      if (!waitingForTemp) {
        stepStartTime = millis() - (pausedElapsedSec * 1000);
      }
      isPaused = false;
    }

    if (isRunning) {
      mixerManualMode = false;
      mixerOn = false;
      mixerPhaseStart = millis();
    }
  }
  server.send(200, "text/plain", "Resumed");
}

static void handleSkipStep() {
  if (isRunning && !waitingForUser) {
    advanceStep();
  }
  server.send(200, "text/plain", "Skipped");
}

static void handleMixerMode() {
  String mode = server.arg("mode");

  if (mode == "manual") {
    mixerManualMode = true;
    // Freeze the relay in its current state; the badge becomes a toggle.
  } else if (mode == "auto") {
    mixerManualMode = false;
    // Resume the on/rest cycle from a fresh phase boundary rather than
    // wherever manual mode happened to leave the relay.
    mixerPhaseStart = millis();
  } else {
    server.send(400, "text/plain", "mode must be 'auto' or 'manual'");
    return;
  }

  server.send(200, "text/plain", "OK");
}

static void handleMixerToggle() {
  if (!mixerManualMode) {
    server.send(409, "text/plain", "Mixer is in auto mode");
    return;
  }

  mixerOn = !mixerOn;
  mixerPhaseStart = millis();
  server.send(200, "text/plain", mixerOn ? "On" : "Off");
}

static void handleEnableOta() {
  if (!otaStarted) {
    ArduinoOTA.begin();
    otaStarted = true;
  }

  otaActivatedAt = millis();
  otaEnabled = true;
  handleFileRead("/ota.html");
}

static void handleUpdateUpload() {
  if (!otaEnabled) return;

  HTTPUpload &upload = server.upload();

  if (upload.status == UPLOAD_FILE_START) {
    updateFailed = false;
    updateReceived = false;

    const bool filesystem = server.arg("type") == "filesystem" || server.hasArg("filesystem") ||
                isFilesystemImage(upload.filename);
    const int command = filesystem ? U_FS : U_FLASH;
    const size_t maxUpdateSize = filesystem
                                   ? filesystemSize()
                     : (ESP.getFreeSketchSpace() - 0x1000);

    Serial.printf("OTA upload started: %s (%s)\n",
                  upload.filename.c_str(), filesystem ? "LittleFS" : "firmware");

    if (!Update.begin(maxUpdateSize, command)) {
      Update.printError(Serial);
      updateFailed = true;
    }
  } else if (upload.status == UPLOAD_FILE_WRITE) {
    if (!updateFailed && Update.write(upload.buf, upload.currentSize) != upload.currentSize) {
      Update.printError(Serial);
      updateFailed = true;
    }
  } else if (upload.status == UPLOAD_FILE_END) {
    if (!updateFailed && !Update.end(true)) {
      Update.printError(Serial);
      updateFailed = true;
    }
    updateReceived = true;
    Serial.printf("OTA upload finished: %u bytes\n", upload.totalSize);
  }
}

static void handleUpdateResult() {
  if (!otaEnabled) {
    server.send(403, "text/plain", "OTA is not enabled");
    return;
  }

  if (!updateReceived || updateFailed || Update.hasError()) {
    server.send(500, "text/plain", "Update failed");
    return;
  }

  server.send(200, "text/plain", "Update successful. Restarting...");
  scheduleRestart(2000);
}

static void handleStatus() {
  StaticJsonDocument<1024> doc;

  doc["running"] = isRunning;
  doc["sensorDebugFake"] = sensorUsingFakeMode();
  doc["calibrationActive"] = calibrationIsActive();
  doc["paused"] = isPaused;
  doc["waitingForUser"] = waitingForUser;
  doc["residualHeatRecovery"] = residualHeatRecoveryActive;
  doc["alertSound"] = storage.settings().alertSoundEnabled;
  doc["profileName"] = activeProfile.name;
  doc["waterMassKg"] = activeProfile.waterMassKg;
  doc["grainMassKg"] = activeProfile.grainMassKg;
  doc["step"] = currentStep;
  if (isRunning) {
    JsonArray steps = doc.createNestedArray("steps");
    for (int i = 0; i < activeProfile.stepCount; i++) {
      JsonObject step = steps.createNestedObject();
      step["temp"] = round1(activeProfile.steps[i].temp);
      step["time"] = activeProfile.steps[i].time;
    }
  }
  doc["stepTemp"] = round1(targetTemperature);
  doc["currentTemp"] = sensorFound && sensorOk ? round1(readTemperature()) : -127;
  doc["heaterOn"] = heaterOutputActive();
  doc["coolerOn"] = coolerOn;
  const float predictedPeak = heaterPredictedPeak();
  if (isfinite(predictedPeak)) doc["predictedPeak"] = predictedPeak;

  doc["mixerOn"] = mixerOn;
  doc["mixerMode"] = mixerManualMode ? "manual" : "auto";
  doc["mixerRemaining"] = mixerManualMode ? 0 : mixerRemainingSec();

  if (isRunning) {

      if (waitingForTemp) {
          // Timer has NOT started yet
          doc["remaining"] = stepDurationSec;   // full time
          doc["waiting"] = true;
      } else if (isPaused) {
          // Timer is frozen at the banked elapsed value
          long remaining = stepDurationSec - pausedElapsedSec;
          if (remaining < 0) remaining = 0;

          doc["remaining"] = remaining;
          doc["waiting"] = false;
      } else {
          // Timer is running
          unsigned long elapsed = (millis() - stepStartTime) / 1000;
          long remaining = stepDurationSec - elapsed;
          if (remaining < 0) remaining = 0;

          doc["remaining"] = remaining;
          doc["waiting"] = false;
      }
  }

  // Cool-down status
  doc["coolDownActive"] = inCoolDown;
  if (inCoolDown) {
    SettingsEE &s = storage.settings();
    unsigned long coolDownElapsed = (millis() - coolDownStart) / 1000;
    long remaining = s.coolDownSec - coolDownElapsed;
    if (remaining < 0) remaining = 0;
    doc["coolDownRemaining"] = remaining;
  }

  String out;
  serializeJson(doc, out);
  server.send(200, "application/json", out);
}

/* -------------------------------------------------------------------------- */
/*                                  ROUTES                                    */
/* -------------------------------------------------------------------------- */

void webHandlersInit() {
  server.on("/", []() { handleFileRead("/index.html"); });
  server.on("/index.html", []() { handleFileRead("/index.html"); });
  server.on("/favicon.ico", []() { handleFileRead("/favicon.ico"); });
  server.on("/style.css", []() { handleFileRead("/style.css"); });
  server.on("/script.js", []() { handleFileRead("/script.js"); });
  server.on("/icons.js", []() { handleFileRead("/icons.js"); });
  server.on("/chart.js", []() { handleFileRead("/chart.js"); });
  server.on("/ota.html", []() { handleFileRead("/ota.html"); });
  server.on("/calibration.html", []() { handleFileRead("/calibration.html"); });
  server.on("/calibration.js", []() { handleFileRead("/calibration.js"); });
  server.on("/PredictivePeakDeadband.png", []() { handleFileRead("/PredictivePeakDeadband.png"); });
  server.on("/enable-ota", HTTP_GET, handleEnableOta);
  server.on("/update", HTTP_POST, handleUpdateResult, handleUpdateUpload);

  server.on("/profiles_data", HTTP_GET, handleGetProfiles);
  server.on("/saveProfiles", HTTP_POST, handleSaveProfiles);

  server.on("/settings", HTTP_GET, handleGetSettings);
  server.on("/saveSettings", HTTP_POST, handleSaveSettings);
  server.on("/rediscoverSensor", HTTP_POST, handleRediscoverSensor);

  server.on("/data", handleData);
  server.on("/startProfile", HTTP_POST, handleStartProfile);
  server.on("/stopProfile", HTTP_POST, handleStopProfile);
  server.on("/pauseProfile", HTTP_POST, handlePauseProfile);
  server.on("/resumeProfile", HTTP_POST, handleResumeProfile);
  server.on("/skipStep", HTTP_POST, handleSkipStep);
  server.on("/mixerMode", HTTP_POST, handleMixerMode);
  server.on("/mixerToggle", HTTP_POST, handleMixerToggle);
  server.on("/status", handleStatus);
  server.on("/calibrationStart", HTTP_POST, handleCalibrationStart);
  server.on("/calibrationStop", HTTP_POST, handleCalibrationStop);
  server.on("/calibrationStatus", HTTP_GET, handleCalibrationStatus);
  server.on("/reboot.html", []() { handleFileRead("/reboot.html"); });
  server.on("/reboot.htm", []() { handleFileRead("/reboot.html"); });
  server.on("/reboot", HTTP_GET, []() { handleFileRead("/reboot.html"); });
  server.on("/reboot", HTTP_POST, []() {
    server.send(200, "text/plain", "Rebooting...");
    scheduleRestart(1000);
  });
}

void otaUpdate() {
  if (!otaEnabled) return;

  if (millis() - otaActivatedAt >= OTA_TIMEOUT_MS) {
    otaEnabled = false;
    Serial.println("OTA window expired");
    return;
  }

  ArduinoOTA.handle();
}
