nppc/MashController/MashController_pio/include/WebHandlers.h

#ifndef WEB_HANDLERS_H
#define WEB_HANDLERS_H

#include <ESP8266WebServer.h>

extern ESP8266WebServer server;
extern bool otaEnabled;

// Registers every HTTP route. Call once from setup(), after storage.begin()
// (settings must be loaded before WiFi.softAP() runs, which happens
// between storage.begin() and this call in the main .ino).
void webHandlersInit();

// Services the OTA handler only while the explicitly armed window is active.
void otaUpdate();

// Enable or disable mDNS responder at runtime (http://mash.local)
void setMdnsEnabled(bool enabled);

#endif
