nppc/MashController/(commit log)

2026-09-05 Define pins for SSR and mosfet
2026-09-07 Move to Platformio and Mixer PWM
2026-09-08 Add double reset to clear wifi password
    [DoubleReset.cpp, main.cpp]
2026-09-19 Pin remap
2026-09-19 Heater logic changed
2026-09-20 Make temperature more stable
2026-09-20 Heating logic changed and autocalibration added
2026-09-21 Fix profile steps handling
    [MashProfile.cpp, MashProfile.h, Outputs.cpp, WebHandlers.cpp]
2026-09-22 Start Mixer from lower PWM
2026-09-23 lineup the calibration page with current style
2026-09-24 New heating control and calibration logic
2026-09-25 fix heater behavior on pause
    [Outputs.cpp, WebHandlers.cpp]
2026-09-25 Cooler state depends on heater
2026-09-26 Ambient temperature from Settings
2026-09-26 hardcoded temperature cleanup
2026-09-26 Prevent editing initial calibration values
    [Config.h]
2026-09-26 Temperature updated online in the Settings
2026-09-26 Current temperature update fix. Only status update provides it
2026-09-28 make delete button and Edit profiles style a bit more easy
2026-09-28 Rework add/delete buttons style
    [WebHandlers.cpp]
2026-09-30 Refactor heatEndSec handling with calibrationHeatEnd
2026-10-01 Update README with hardware details and pin assignments
    Added hardware wiring diagram, parts list, and pin assignments to README.
2026-10-01 Update README with fan control details and safety warning
    Clarified the optional nature of the fan control and added a warning about mains voltage safety.
2026-10-02 Revise heater control logic for predictive temperature management
    Updated heater temperature control logic to be model-based and predictive, improving stability and reducing overshoot.
2026-10-02 Revise README for clarity and detail
    Updated the README to clarify the functionality of the heater control and mixer logic, including changes to the explanation of manual steps in profiles and safety notices during calibration.
2026-10-02 Allow non-inverted mixer pin
    [Config.h, Outputs.cpp]
2026-10-22 Add whole program timer
2026-10-22 Rework calibration and temperature control to make it closer to real world
2026-10-23 Fix fake sensor behavior
2026-10-23 Heater deadband as a constant in the code
2026-10-27 Fake sensor settings cosmetic adjust
2026-11-06 Adjust DEBUG sensor behavior when grain is added
2026-11-06 Fix temperature control after grain is added as well as after unintended hardware reset
